OmkarTikekar0037/FPGA_Architecture_project/VERISHOT_HDL Documentation/VERISHOT_HDL.md

**Keywords**

* input
* output
* assign

**Identifiers**

* A
* B
* C
* Y
* \[A-Za-z\_]\[A-Za-z0-9\_]\* formula -- first character → letter or \_  .subsequent characters → letter, digit, or \_  .

**Operators**

* \&       AND
* |       OR
* ^       XOR
* \~       NOT

**Punctuation**

* ( )
* ;
* ,
* =
