OmkarTikekar0037/FPGA_Architecture_project/PLOTS/PCB_MP_09-B_Cu.pdf

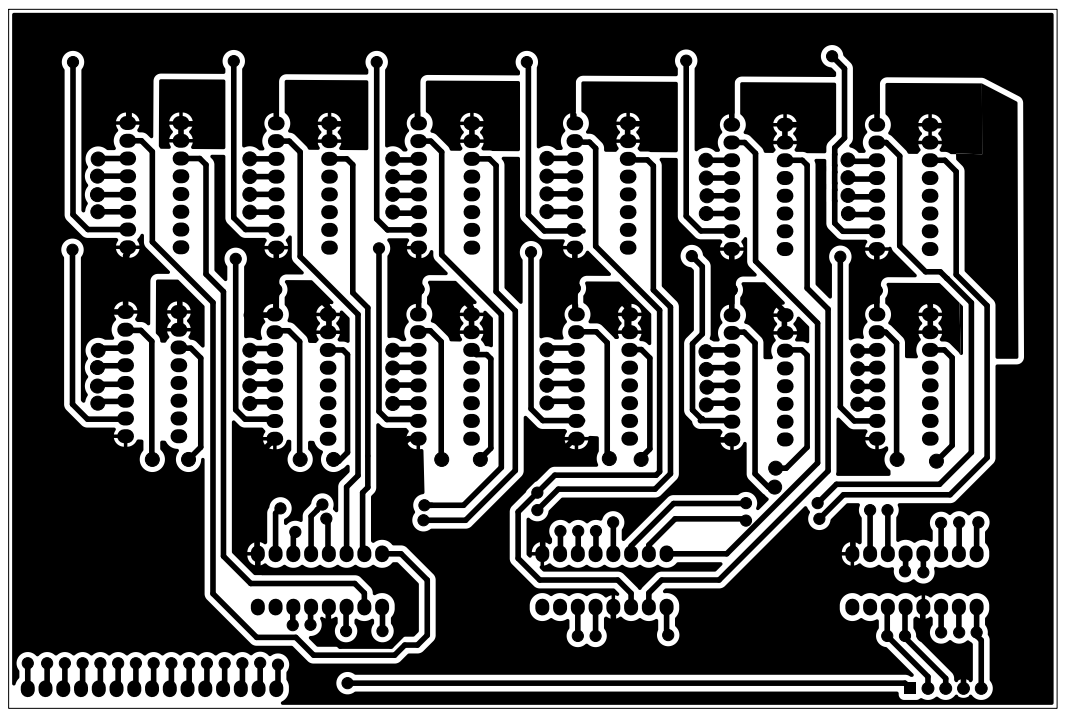
[picture p1: page 1]
