OmkarTikekar0037/FPGA_Architecture_project/(list of files, drawings)

Other design files:
LUT_v2.circ
