OmkarTikekar0037/FPGA_Architecture_project/STM32/VERISHOT_compiler/VERISHOT_compiler.ioc

Mcu.UserName=STM32F401CCUx
PA10.Signal=USART1_RX
PA13.Signal=SYS_JTMS-SWDIO
PA14.Signal=SYS_JTCK-SWCLK
PA9.Signal=USART1_TX
