OmkarTikekar0037/FPGA_Architecture_project/(commit log)

2026-08-23 Interfaced 2 LUTs: 2 Pending
    [LUT_v2.circ]
2026-09-08 switching matrix mux changed to 4:1
    [LUT_v2.circ]
2026-09-08 resolved splitter error
    [LUT_v2.circ]
2026-09-08 Documentations and Lexer added in STM32
    [LUT_v2.circ]
2026-09-22 verishot_semantic files added to stm32
2026-09-23 Schematics: initial commit
    [PCB_MP.kicad_pcb, PCB_MP.kicad_sch, PCB_MP_09.kicad_pcb, PCB_MP_09.kicad_sch]
2026-09-26 schematics: muxes and shift registers added
    [4to1mux.kicad_sch, LUT_v2.circ, PCB_MP_09.kicad_pcb, PCB_MP_09.kicad_sch]
2026-09-26 schematics: Bus architecture for config and switch bits is used
    [4to1mux.kicad_sch, LUT_v2.circ, PCB_MP_09.kicad_pcb, PCB_MP_09.kicad_sch]
2026-09-28 Logisim: 8bit sipo registers included:: Schematics:switch matrix regs connected
    [4to1mux.kicad_sch, LUT_v2.circ, PCB_MP_09.kicad_pcb, PCB_MP_09.kicad_sch, switch_control_regs.kicad_sch]
2026-10-04 Arduino: FPGA config bit working
    [4to1mux.kicad_sch, LUT_v2.circ, PCB_MP_09.kicad_pcb, PCB_MP_09.kicad_sch]
2026-10-06 migrated stm32 compiler code to esp32 (no bitstream yet)
    [4to1mux.kicad_sch, PCB_MP_09.kicad_pcb, PCB_MP_09.kicad_sch, switch_control_regs.kicad_sch]
2026-10-08 PCB Designed for all the schematics
    [4to1mux.kicad_sch, PCB_MP_09.kicad_pcb, PCB_MP_09.kicad_sch]
